Needleroozer/Nixies/README.md

# Nixies

A GitHub repository for collecting various Nixie tube PCB designs and the code that goes with them
