Needleroozer/Nixies/hardware/nixie-controller/controller schematic.pdf

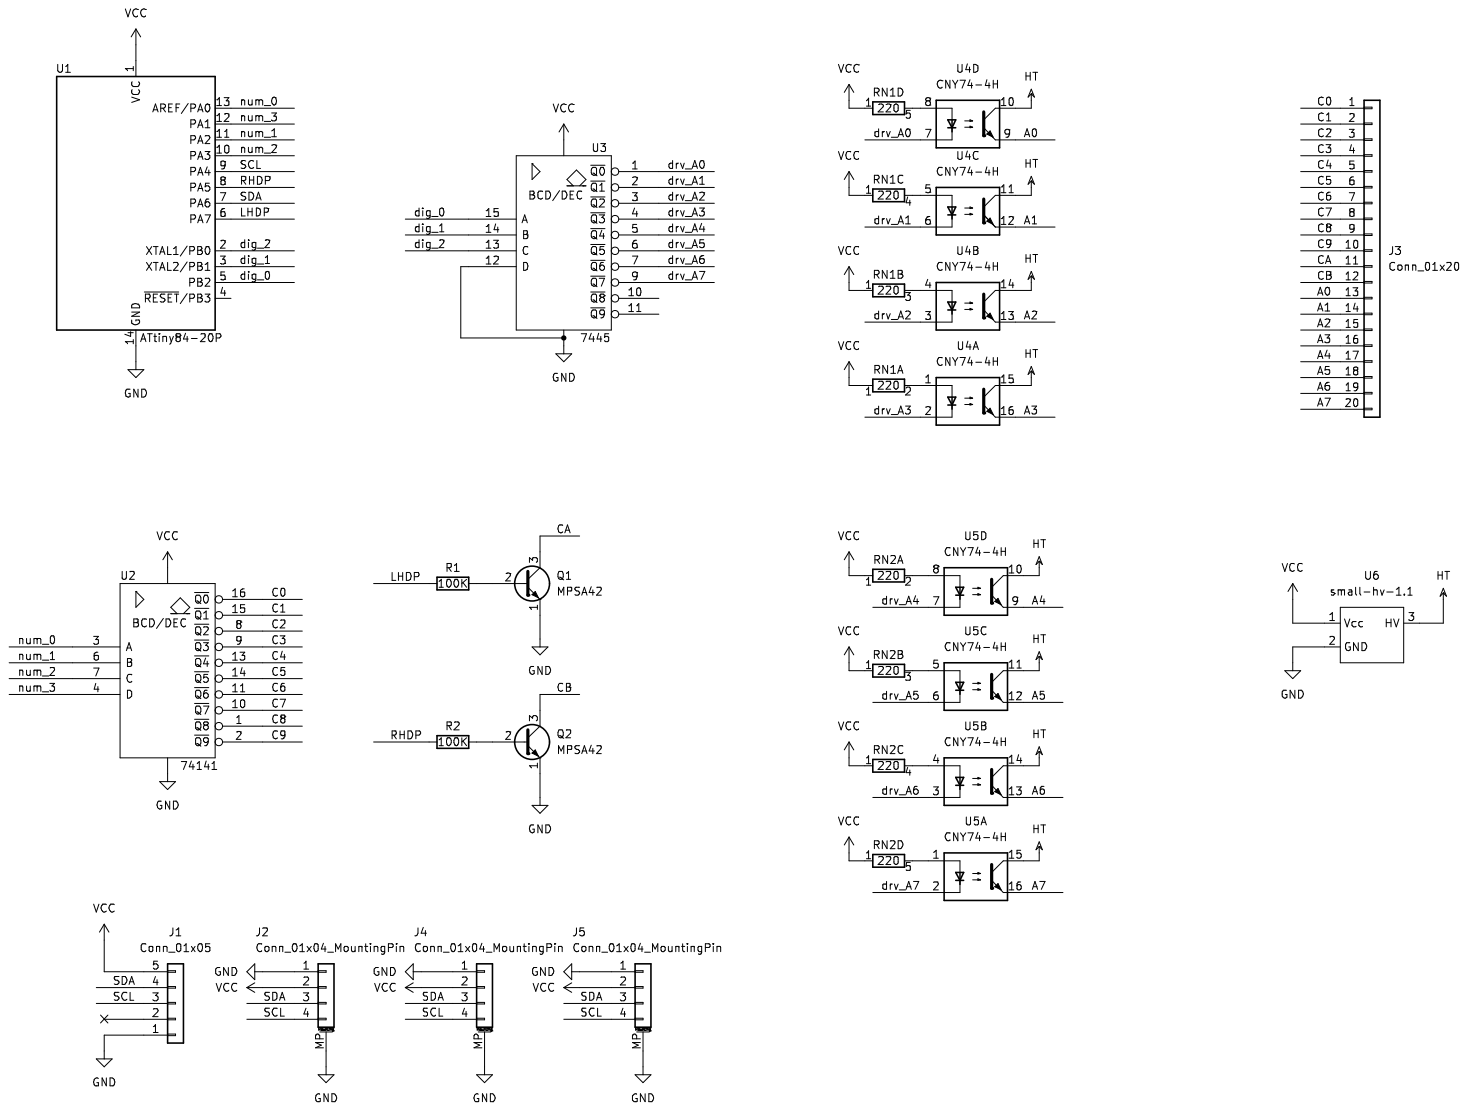
[picture p1: page 1]
