Needleroozer/Nixies/hardware/in-16-carrier/in-16-carrier.kicad_pcb

## KiCad design hardware/in-16-carrier/in-16-carrier.kicad_pcb (2023-10-01)

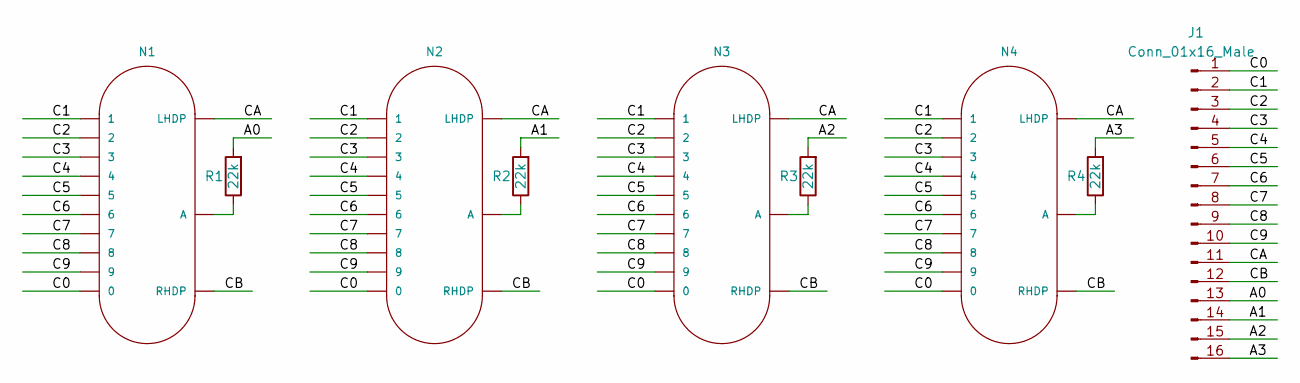
[picture p2: schematic in-16-carrier.kicad_sch]

Parts:
J1: Conn_01x16_Male; PinHeader_1x16_P2.54mm_Vertical
N1, N2, N3, N4: IN-16; nixies-us-IN-16
R1, R2, R3, R4: 22k; R_Axial_DIN0207_L6.3mm_D2.5mm_P10.16mm_Horizontal

Connections:
/A0: J1.13, R1.2
/A1: J1.14, R2.2
/A2: J1.15, R3.2
/A3: J1.16, R4.2
/C0: J1.1, N1.0, N2.0, N3.0, N4.0
/C1: J1.2, N1.1, N2.1, N3.1, N4.1
/C2: J1.3, N1.2, N2.2, N3.2, N4.2
/C3: J1.4, N1.3, N2.3, N3.3, N4.3
/C4: J1.5, N1.4, N2.4, N3.4, N4.4
/C5: J1.6, N1.5, N2.5, N3.5, N4.5
/C6: J1.7, N1.6, N2.6, N3.6, N4.6
/C7: J1.8, N1.7, N2.7, N3.7, N4.7
/C8: J1.9, N1.8, N2.8, N3.8, N4.8
/C9: J1.10, N1.9, N2.9, N3.9, N4.9
/CA: J1.11, N1.LHDP, N2.LHDP, N3.LHDP, N4.LHDP
/CB: J1.12, N1.RHDP, N2.RHDP, N3.RHDP, N4.RHDP
unnamed: N1.A, R1.1
unnamed: N2.A, R2.1
unnamed: N3.A, R3.1
unnamed: N4.A, R4.1

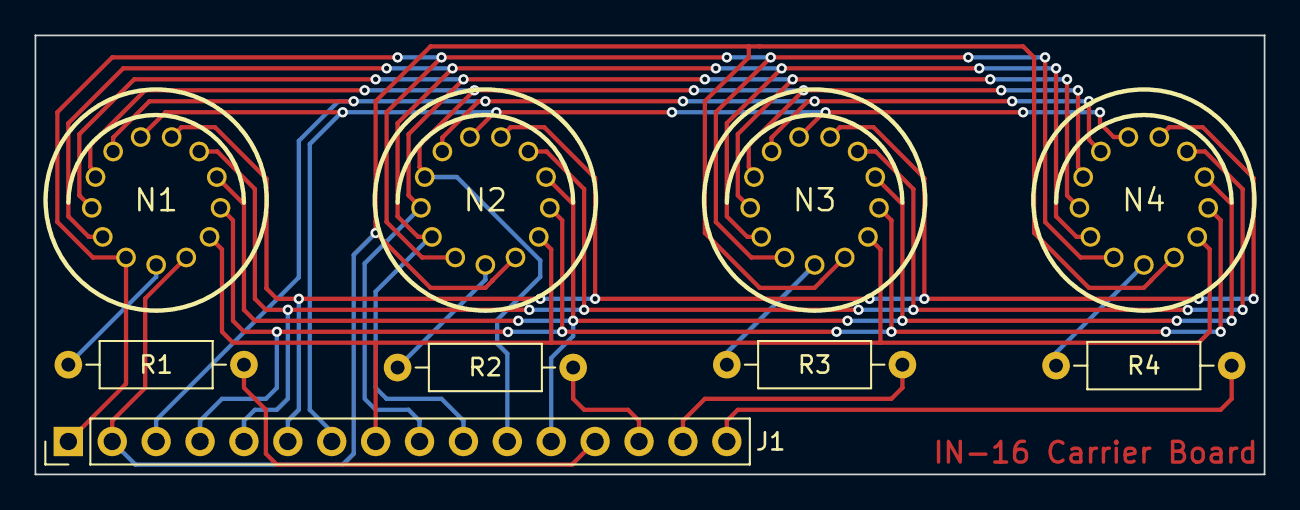
[picture p3: board in-16-carrier.kicad_pcb from above]

Board: 2 copper layers, 71.1 x 25.4 mm, 9 parts (0 on the bottom side), 20 nets.
