Needleroozer/Nixies/hardware/nixie-controller/nixie-controller.kicad_pcb

## KiCad design hardware/nixie-controller/nixie-controller.kicad_pcb (2023-10-01)

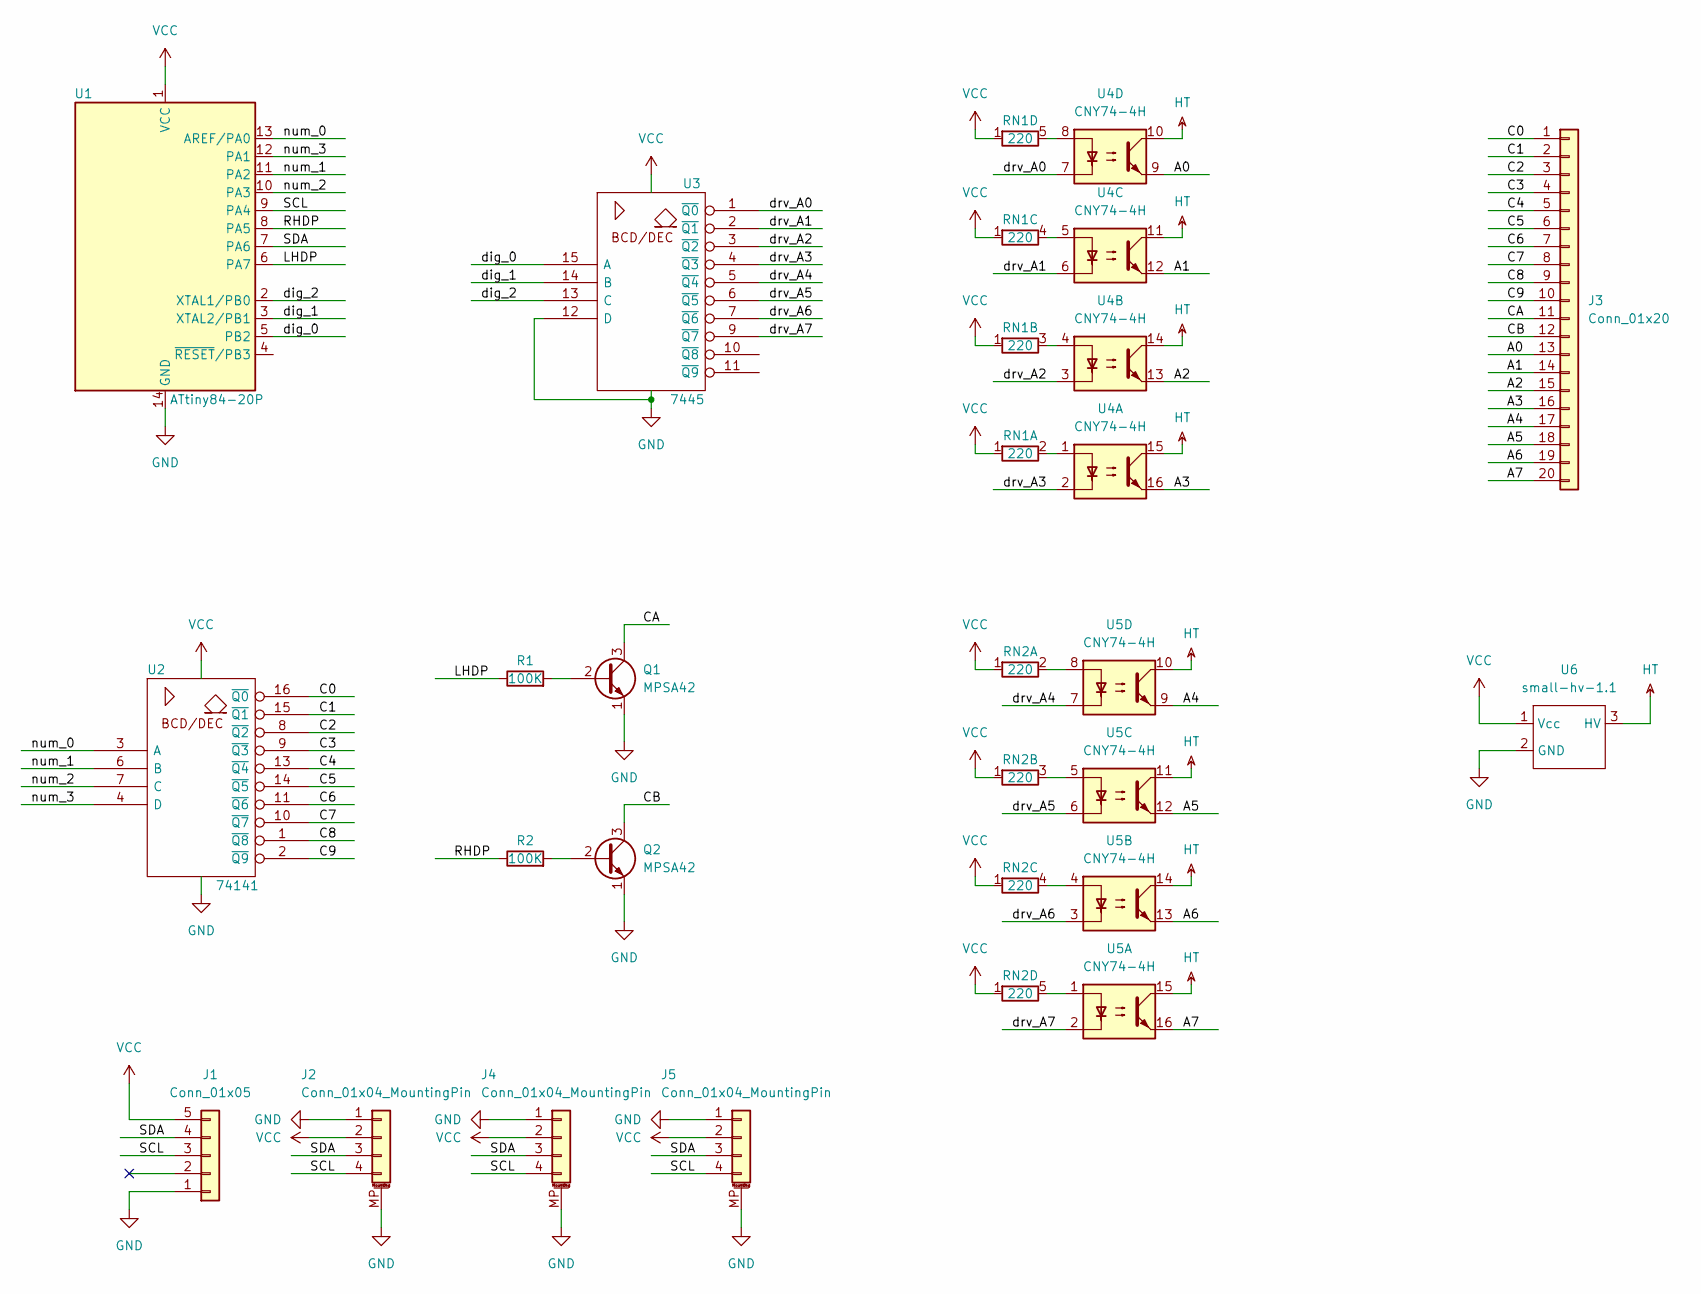
[picture p4: schematic nixie-controller.kicad_sch]

Parts:
J1: Conn_01x05; PinHeader_1x05_P2.54mm_Vertical
J2, J4, J5: Conn_01x04_MountingPin; JST_SH_SM04B-SRSS-TB_1x04-1MP_P1.00mm_Horizontal
J3: Conn_01x20; PinSocket_1x20_P2.54mm_Vertical
Q1, Q2: MPSA42; TO-92_Inline_Wide
R1, R2: 100K; R_Axial_DIN0207_L6.3mm_D2.5mm_P10.16mm_Horizontal
RN1, RN2: 220; R_Array_SIP5
U1: ATtiny84-20P; DIP-14_W7.62mm
U2: 74141; DIP-16_W7.62mm
U3: 7445; DIP-16_W7.62mm
U4, U5: CNY74-4H; DIP-16_W7.62mm
U6: small-hv-1.1

Connections:
/A0: J3.13, U4.9
/A1: J3.14, U4.12
/A2: J3.15, U4.13
/A3: J3.16, U4.16
/A4: J3.17, U5.9
/A5: J3.18, U5.12
/A6: J3.19, U5.13
/A7: J3.20, U5.16
/C0: J3.1, U2.16 (~Q0)
/C1: J3.2, U2.15 (~Q1)
/C2: J3.3, U2.8 (~Q2)
/C3: J3.4, U2.9 (~Q3)
/C4: J3.5, U2.13 (~Q4)
/C5: J3.6, U2.14 (~Q5)
/C6: J3.7, U2.11 (~Q6)
/C7: J3.8, U2.10 (~Q7)
/C8: J3.9, U2.1 (~Q8)
/C9: J3.10, U2.2 (~Q9)
/CA: J3.11, Q1.3 (C)
/CB: J3.12, Q2.3 (C)
/LHDP: R1.1, U1.6 (PA7)
/RHDP: R2.1, U1.8 (PA5)
/SCL: J1.3, J2.4, J4.4, J5.4, U1.9 (PA4)
/SDA: J1.4, J2.3, J4.3, J5.3, U1.7 (PA6)
/dig_0: U1.5 (PB2), U3.15 (A)
/dig_1: U1.3 (XTAL2/PB1), U3.14 (B)
/dig_2: U1.2 (XTAL1/PB0), U3.13 (C)
/drv_A0: U3.1 (~Q0), U4.7
/drv_A1: U3.2 (~Q1), U4.6
/drv_A2: U3.3 (~Q2), U4.3
/drv_A3: U3.4 (~Q3), U4.2
/drv_A4: U3.5 (~Q4), U5.7
/drv_A5: U3.6 (~Q5), U5.6
/drv_A6: U3.7 (~Q6), U5.3
/drv_A7: U3.9 (~Q7), U5.2
/num_0: U1.13 (AREF/PA0), U2.3 (A)
/num_1: U1.11 (PA2), U2.6 (B)
/num_2: U1.10 (PA3), U2.7 (C)
/num_3: U1.12 (PA1), U2.4 (D)
GND: J1.1, J2.1, J2.MP (MountPin), J4.1, J4.MP (MountPin), J5.1, J5.MP (MountPin), Q1.1 (E), Q2.1 (E), U1.14 (GND), U2.12 (GND), U3.8 (GND), U3.12 (D), U6.2 (GND)
HT: U4.10, U4.11, U4.14, U4.15, U5.10, U5.11, U5.14, U5.15, U6.3 (HV)
unnamed: Q1.2 (B), R1.2
unnamed: Q2.2 (B), R2.2
unnamed: RN1.2 (R1.2), U4.1
unnamed: RN1.3 (R2.2), U4.4
unnamed: RN1.4 (R3.2), U4.5
unnamed: RN1.5 (R4.2), U4.8
unnamed: RN2.2 (R1.2), U5.8
unnamed: RN2.3 (R2.2), U5.5
unnamed: RN2.4 (R3.2), U5.4
unnamed: RN2.5 (R4.2), U5.1
VCC: J1.5, J2.2, J4.2, J5.2, RN1.1 (R1.1), RN2.1 (R1.1), U1.1 (VCC), U2.5 (VCC), U3.16 (VCC), U6.1 (Vcc)

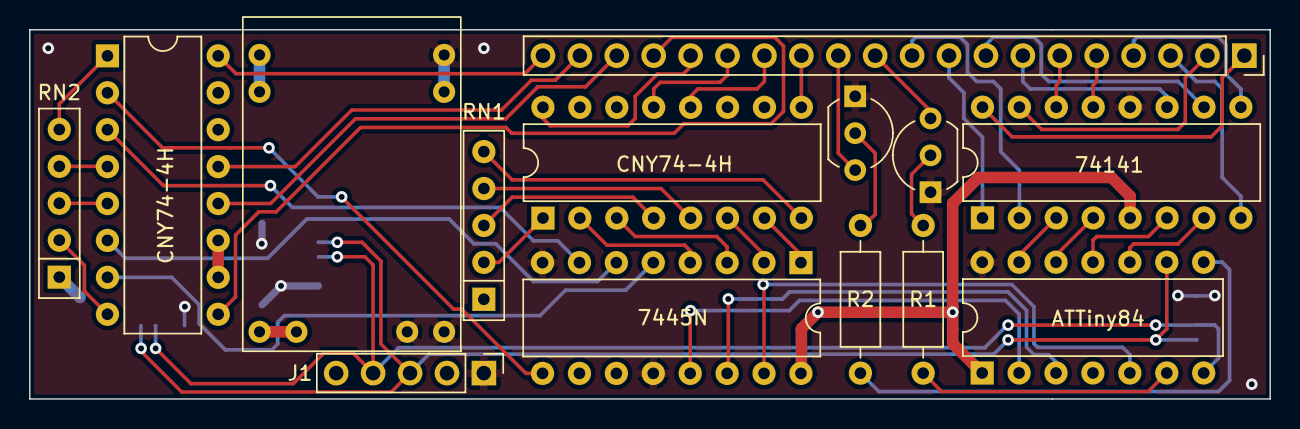
[picture p5: board nixie-controller.kicad_pcb from above]

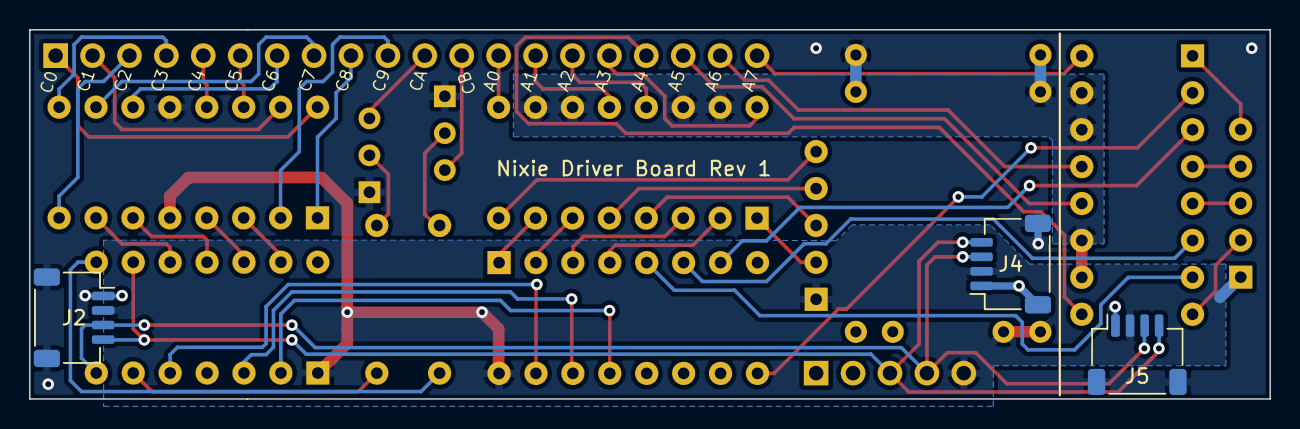
[picture p6: board nixie-controller.kicad_pcb from below]

Board: 2 copper layers, 85.3 x 25.4 mm, 17 parts (3 on the bottom side), 52 nets.
