Needleroozer/Nixies/(commit log)

2023-10-01 Add symbols and footprints from GitHub
    (converted for newer KiCad .pretty format)
    https://github.com/judge2005/Eagle-and-KiCAD-Nixie-Libs
2023-10-01 Add Nixie Controller hardware design
    [nixie-controller.kicad_pcb, nixie-controller.kicad_sch]
2023-10-01 Add IN-16 carrier board
    [in-16-carrier-rounded-B_Cu.gbr, in-16-carrier-rounded-B_Mask.gbr, in-16-carrier-rounded-B_Silkscreen.gbr, in-16-carrier-rounded-Edge_Cuts.gbr, in-16-carrier-rounded-F_Cu.gbr, in-16-carrier-rounded-F_Mask.gbr, in-16-carrier-rounded-F_Silkscreen.gbr, in-16-carrier-rounded-job.gbrjob]
2023-10-06 Finish routing breakaway version, add gerbers
    [nixie-controller-breakaway-B_Cu.gbr, nixie-controller-breakaway-B_Mask.gbr, nixie-controller-breakaway-B_Silkscreen.gbr, nixie-controller-breakaway-Edge_Cuts.gbr, nixie-controller-breakaway-F_Cu.gbr, nixie-controller-breakaway-F_Mask.gbr, nixie-controller-breakaway-F_Silkscreen.gbr, nixie-controller-breakaway-job.gbrjob]
2023-10-06 Add 3-high panelized version for 100x100mm JLCPCB panels
    [nixie-controller-breakaway-panelized-B_Cu.gbr, nixie-controller-breakaway-panelized-B_Mask.gbr, nixie-controller-breakaway-panelized-B_Silkscreen.gbr, nixie-controller-breakaway-panelized-Edge_Cuts.gbr, nixie-controller-breakaway-panelized-F_Cu.gbr, nixie-controller-breakaway-panelized-F_Mask.gbr, nixie-controller-breakaway-panelized-F_Silkscreen.gbr, nixie-controller-breakaway-panelized.drl]
2024-02-25 Add ATTiny84 blinky with PlatformIO and ArduinoISP
2024-02-26 Set fuses for 8MHz clock
    Also only enable anodes for active digits to mitigate ghosting problems
    [main.cpp]
2024-02-27 Bad I2C slave code (barely works)
2024-03-02 Pull USI I2C files from GitHub
    https://github.com/CalcProgrammer1/Stepper-Motor-Controller/tree/master/UnipolarStepperDriver
2024-03-02 Address multi-byte data send bug
    https://github.com/CalcProgrammer1/Stepper-Motor-Controller/issues/3
    [usi_i2c_slave.c]
2024-03-03 First crack at usi_i2c library integration
    [main.cpp, usi_i2c_slave.c]
